Dylan0623/Preliminary-in-2019/README.md

# Preliminary_in_2020
武汉理工大学2020年电赛校赛初赛工程
