Dylan0623/Preliminary-in-2019/N集成运算放大器的应用/PCB工程/集成运算放大器的应用.pdf

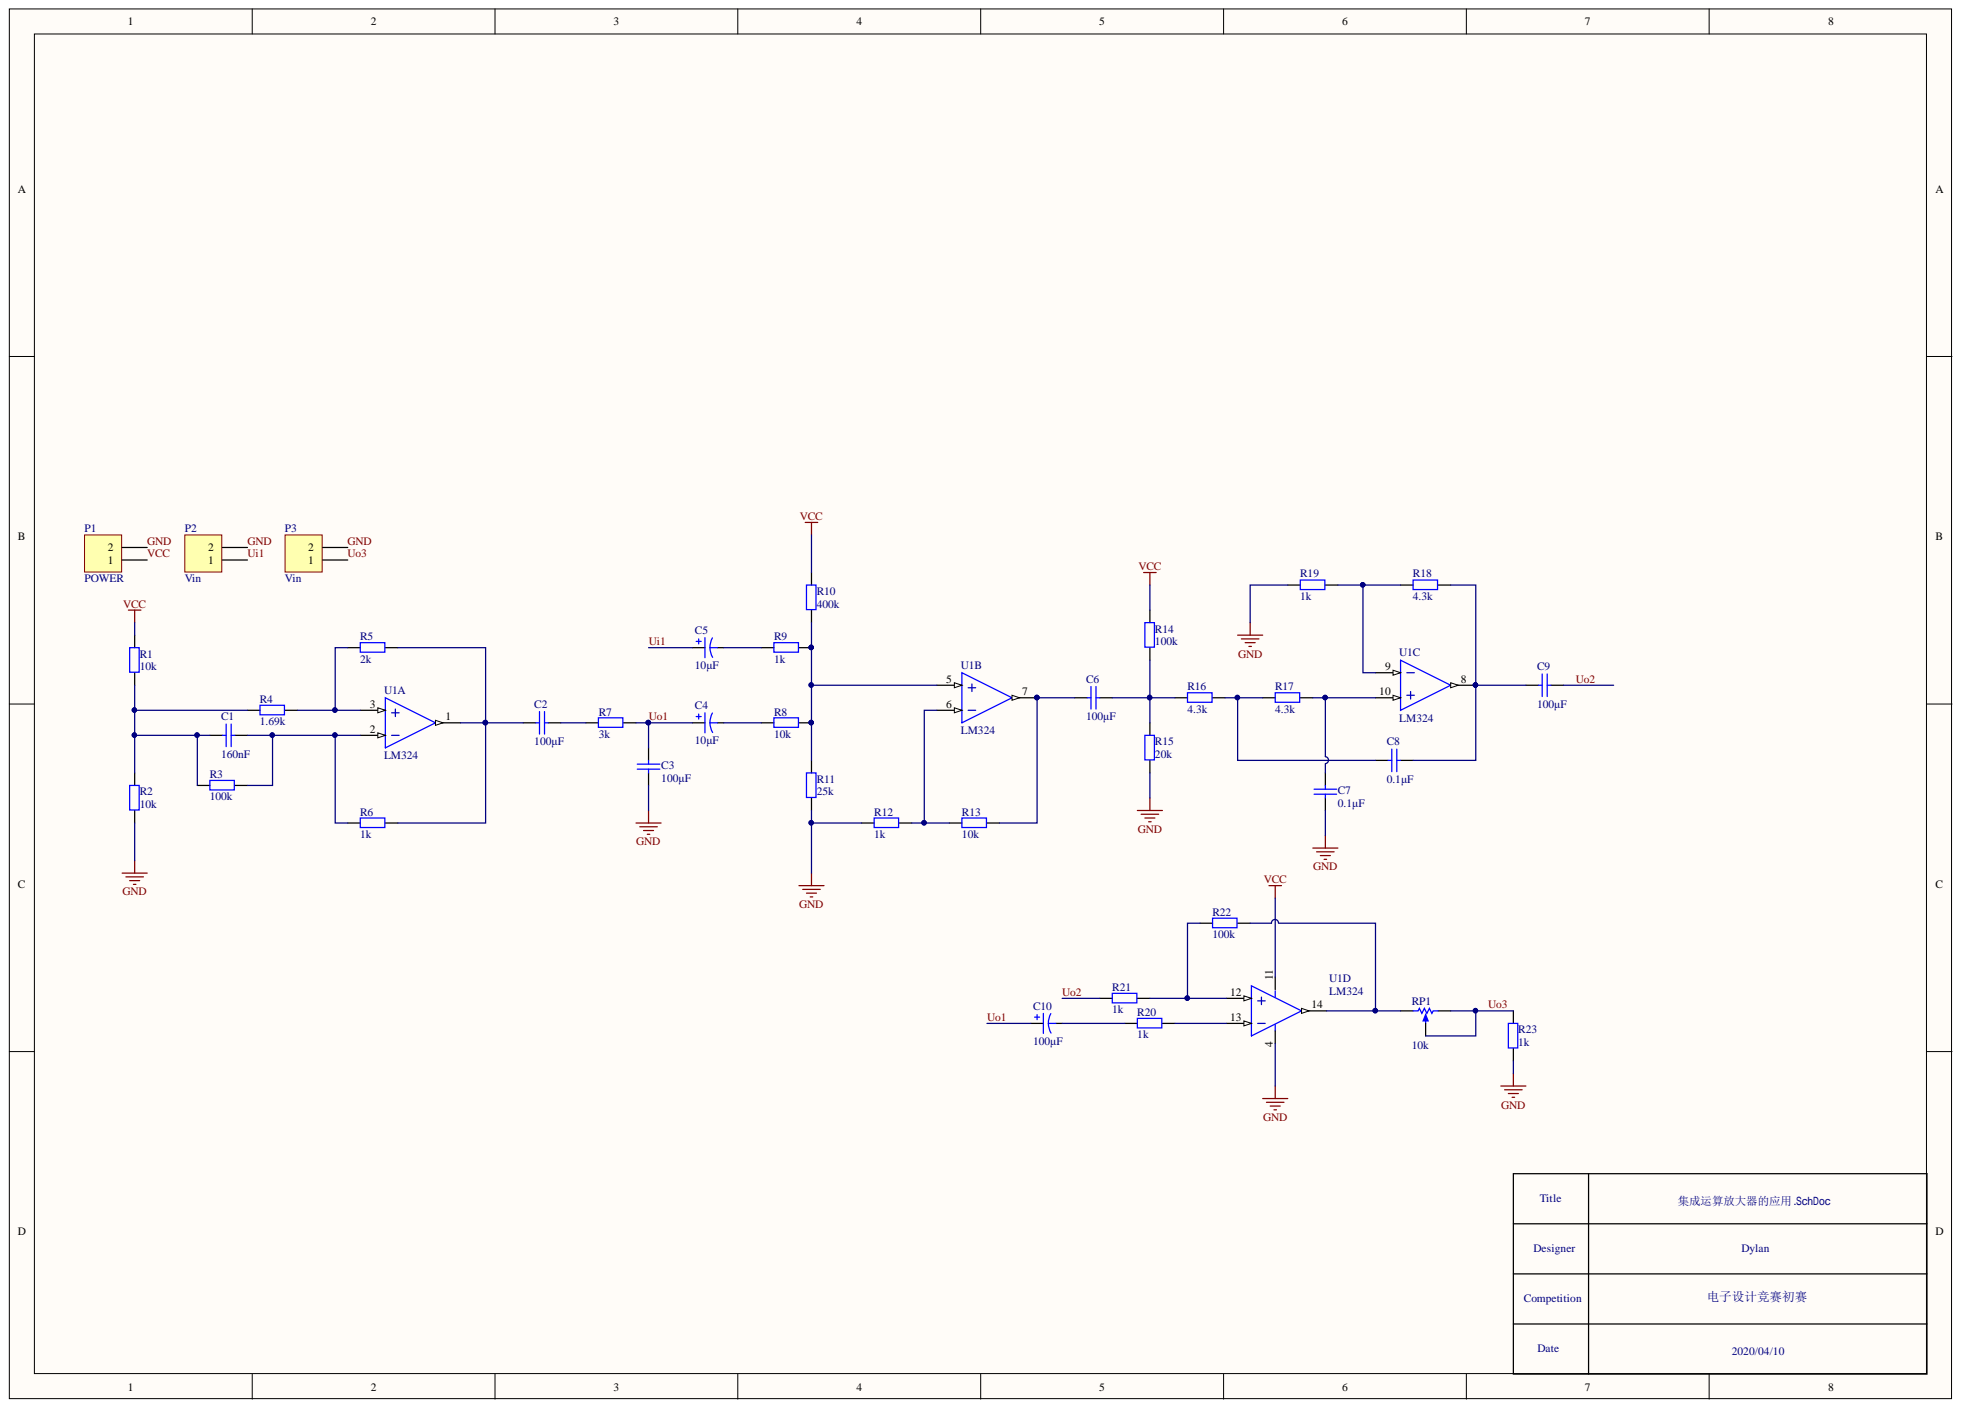
[picture p2: page 1]

Title | 集成运算放大器的应用 SchDoc

Designer | Dylan

Competition | 电子设计竞赛初赛

Date | 2020/04/10

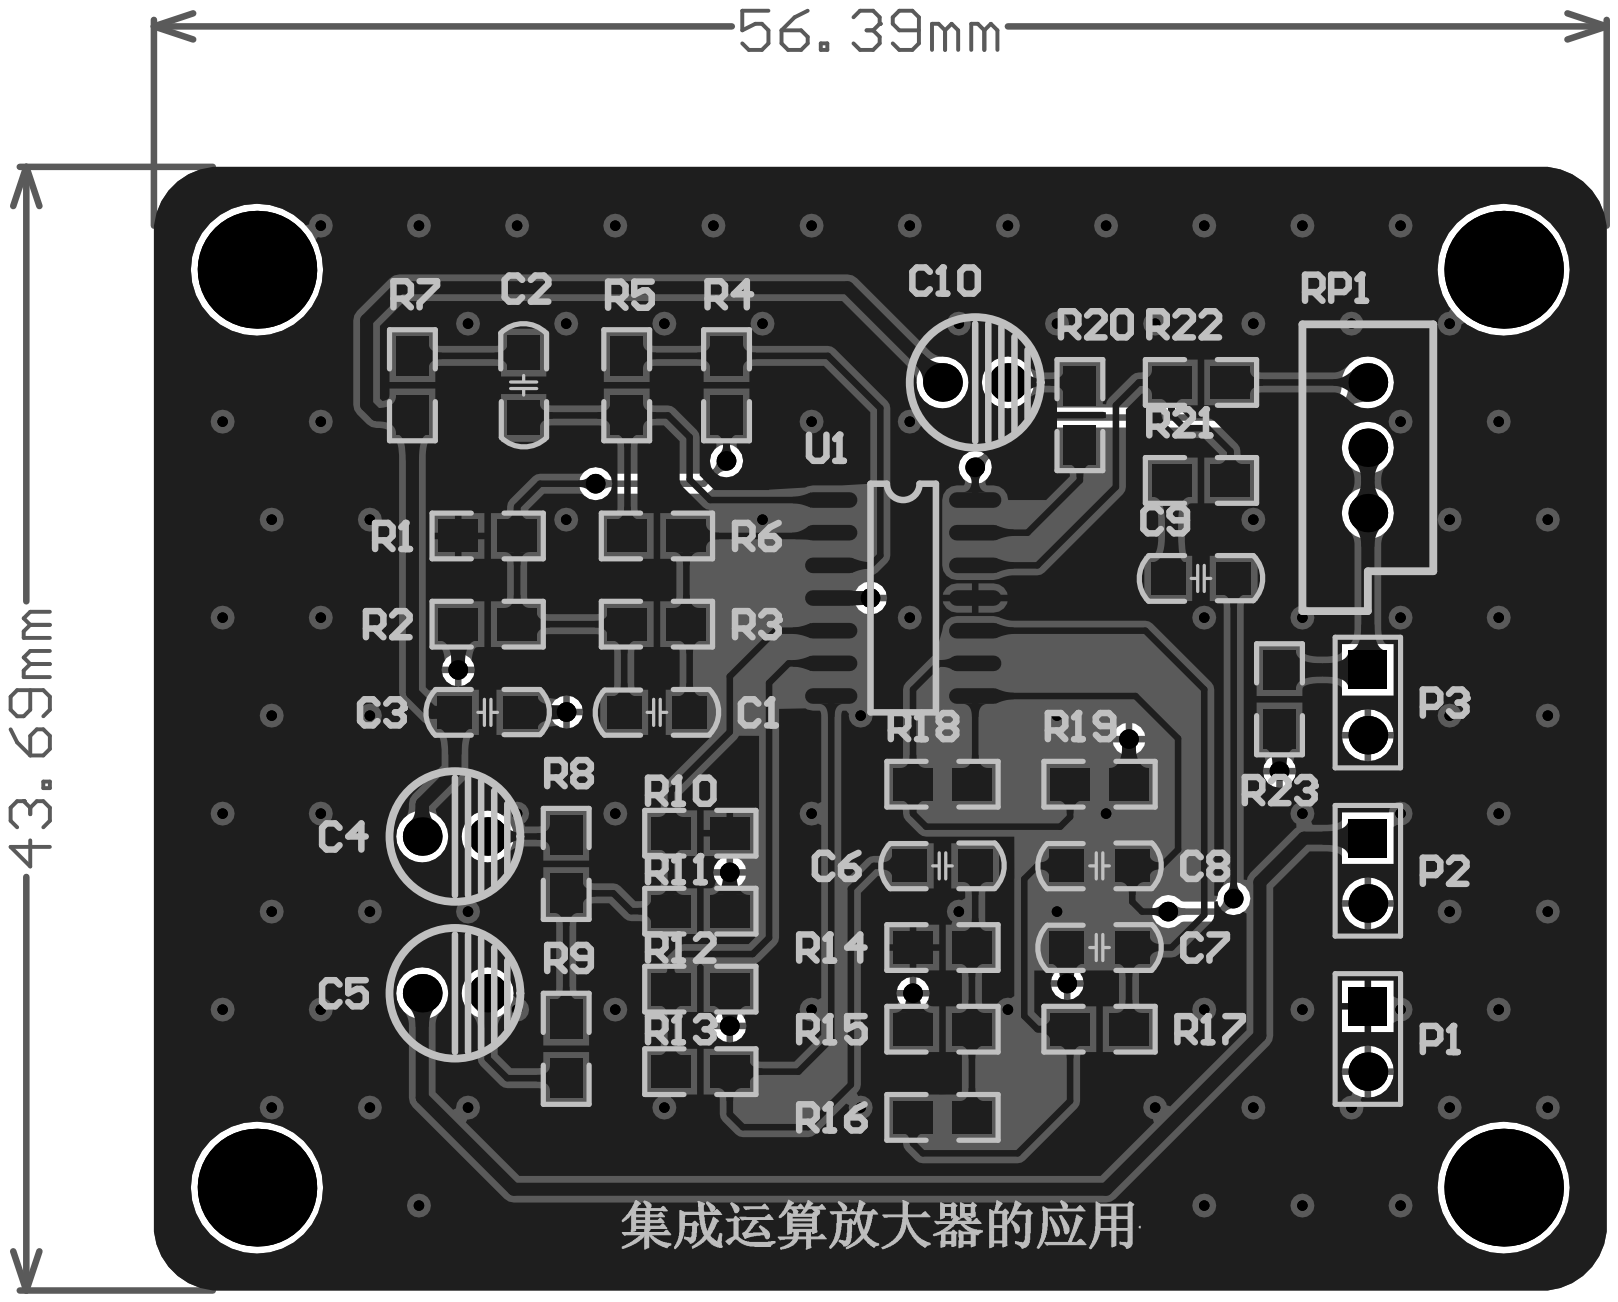
[picture p3: page 2]
