Dylan0623/Preliminary-in-2019/(list of files, drawings)

Other design files:
N集成运算放大器的应用/PCB工程/集成运算放大器的应用.PcbDoc
N集成运算放大器的应用/PCB工程/集成运算放大器的应用.PrjPCB
N集成运算放大器的应用/PCB工程/集成运算放大器的应用.SchDoc
N集成运算放大器的应用/Proteus仿真/集成运算放大器的应用.pdsprj
